Donelook/Differential-Probe/plots/Differential Probe__Assembly.pdf

1 | 2 | 3 | 4 | 5 | 6

A

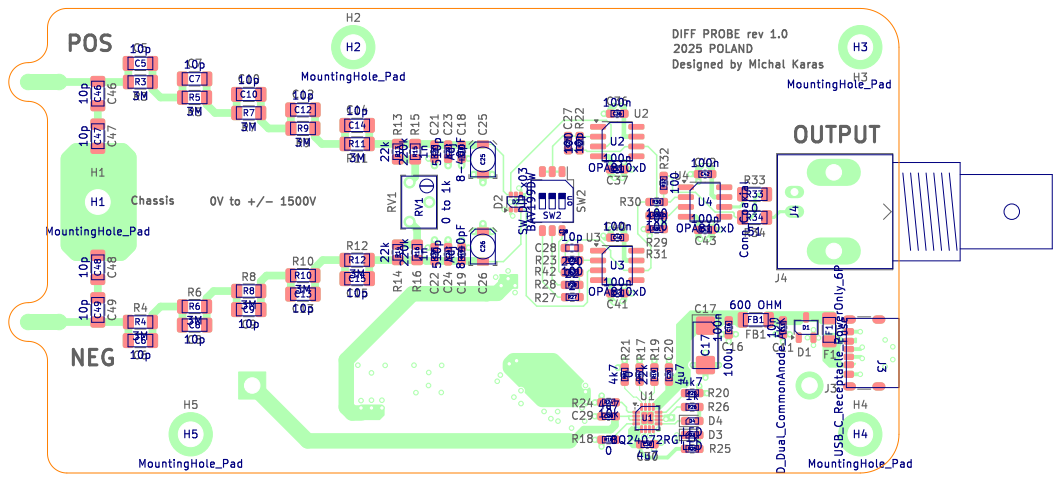
[picture p1: page 1]

A

A

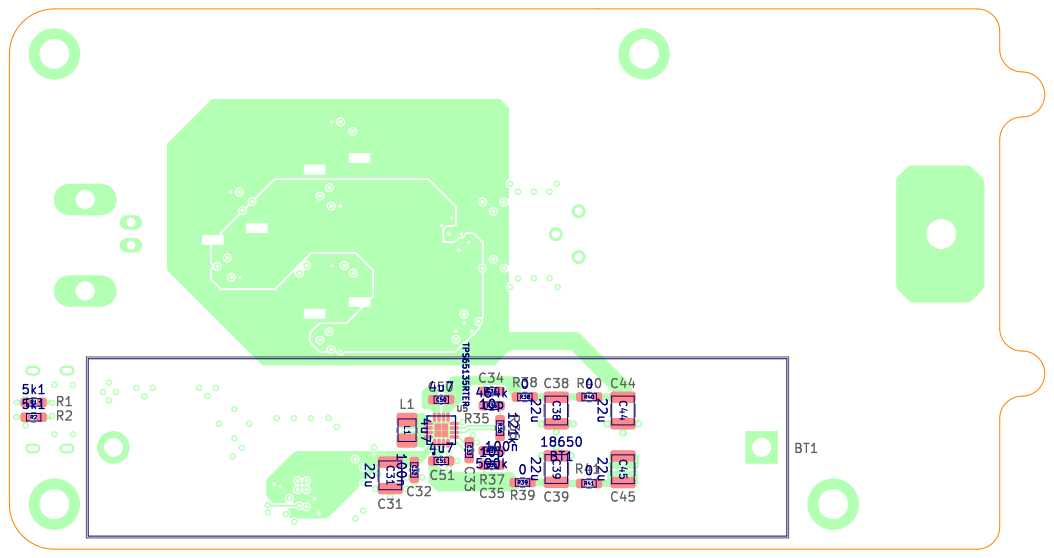
[picture p2: page 2]

A

A

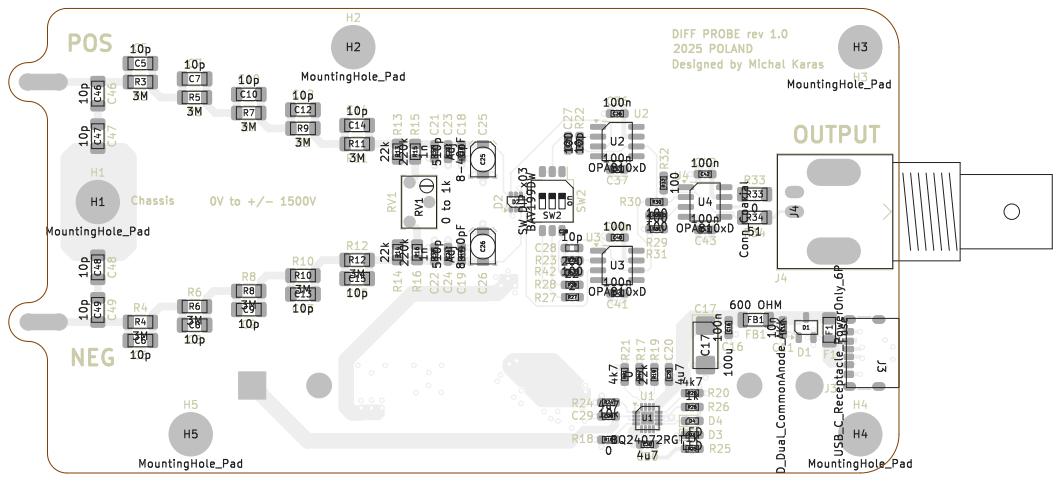
[picture p3: page 3]

A

A

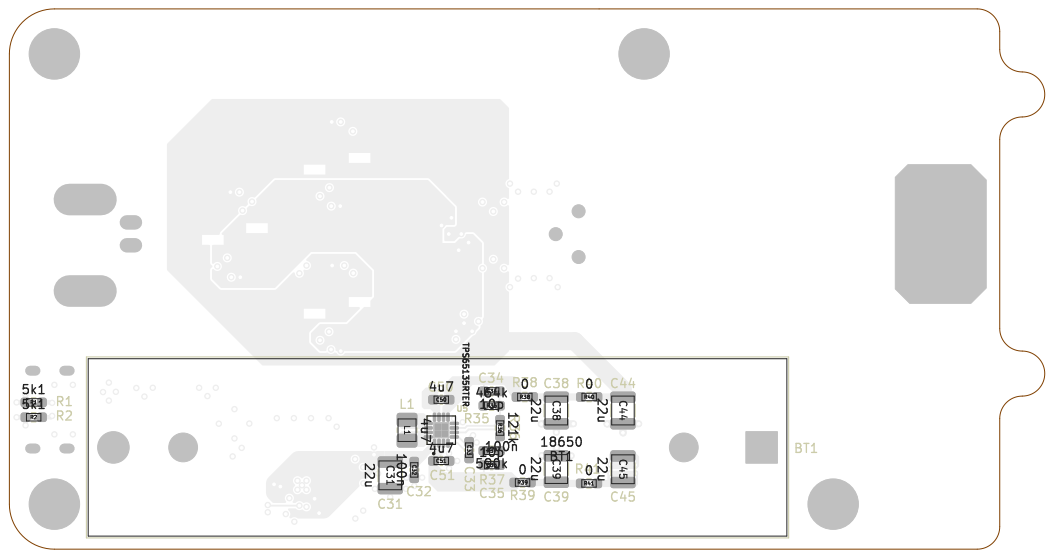
[picture p4: page 4]
