Donelook/Differential-Probe/Symulacja/dIFFERENTIAL PROBE.asc

C1: cap; 10p
C2: cap; 10p
C3: cap; 10p
C4: cap; 10p
C5: cap; 10p
C6: cap; 10p
C7: cap; 10p
C8: cap; 10p
C9: cap; 10p
C10: cap; 10p
C11: cap; 1.51n
C12: cap; 1.51n
C15: cap; 5p; Rser=1m Lser=2n
C16: cap; 5p; Rser=1m Lser=2n
L1: ind; 2n
L2: ind; 2n
R1: res; 3Meg
R2: res; 3Meg
R3: res; 20k
R4: res; 3Meg
R5: res; 3Meg
R6: res; 3Meg
R7: res; 3Meg
R8: res; 3Meg
R9: res; 3Meg
R10: res; 3Meg
R11: res; 3Meg
R12: res; 20k
R13: res; 100
R14: res; 100
R15: res; 200
R16: res; 100
R17: res; 100
R18: res; 100
R19: res; 100
R20: res; 1Meg
R21: res; 50
U1: OPA820
U2: OPA820
U3: OPA820
V1: voltage; SINE(0 1500 100meg); AC ac 1; Rser=1m
V2: voltage; 6
V3: voltage; 6
V4: voltage; 12
V5: Ammeter
V6: Ammeter
V7: Ammeter
Named nets: 0, plus_, minus_, in+, in-, zas+, zas-, out, test-, test+, +12
.ac dec 1000 1000 1000meg
4Vpp, 2V amplitude for 1500V
8Vpp, 4V amplitude
0.0013315579 GAIN
.ac dec 1000 1000 1000meg
;ac dec 1000 1000 1000meg
.tran 100u
