Donelook/Differential-Probe/Differential Probe.kicad_pcb

## KiCad design Differential Probe.kicad_pcb (2025-03-30)

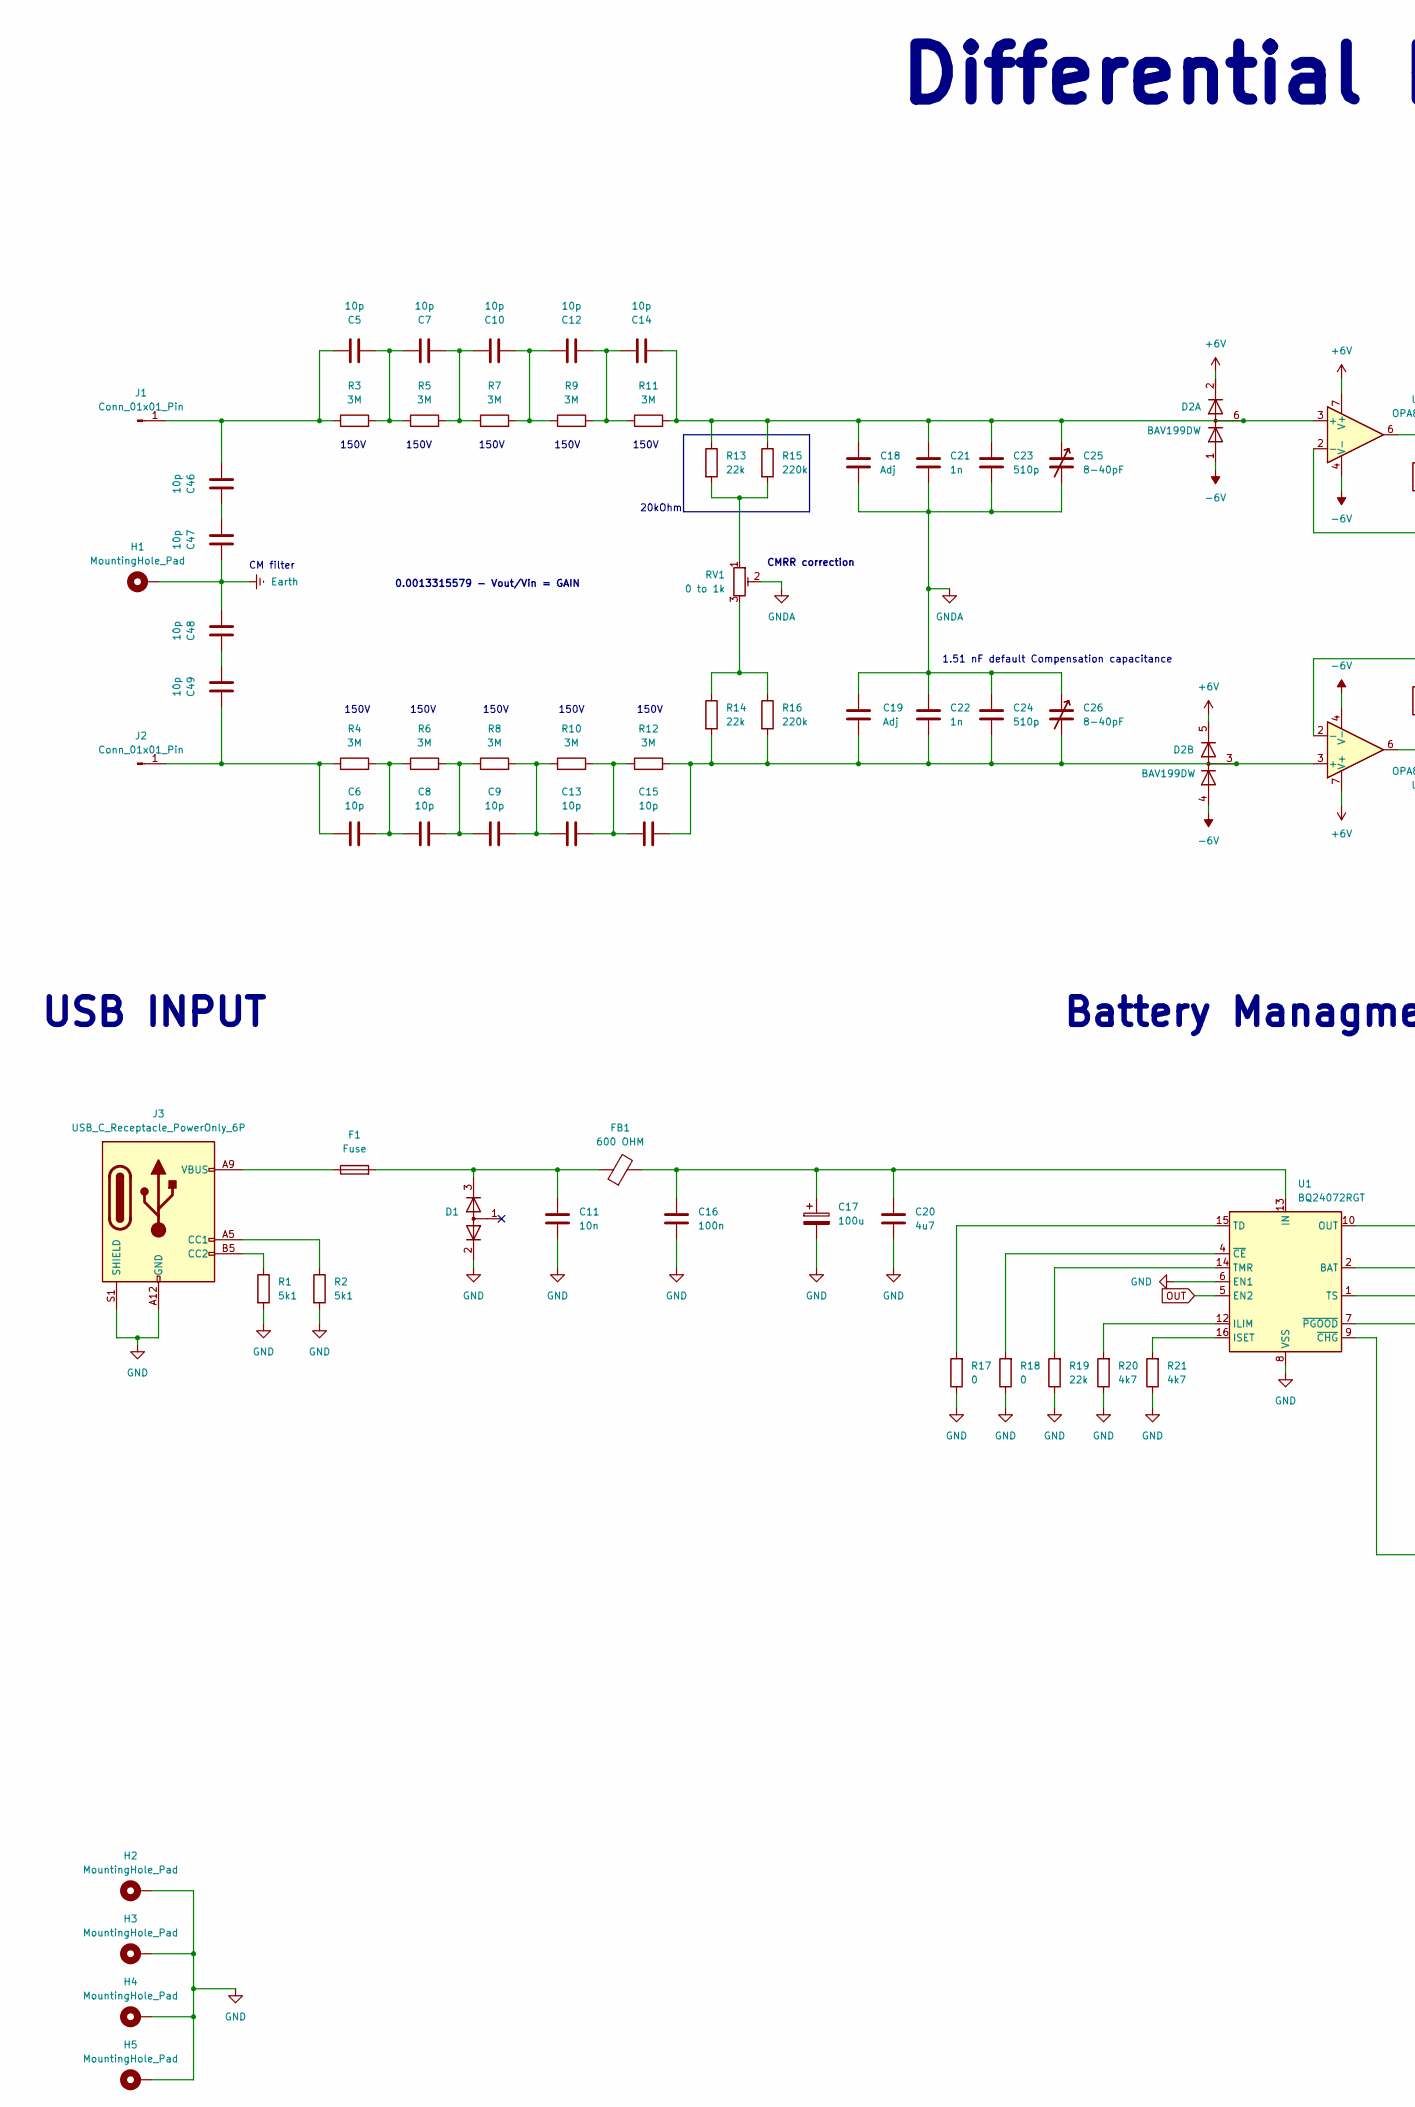
[picture p5: schematic Differential Probe.kicad_sch, part in row 1, column 1]

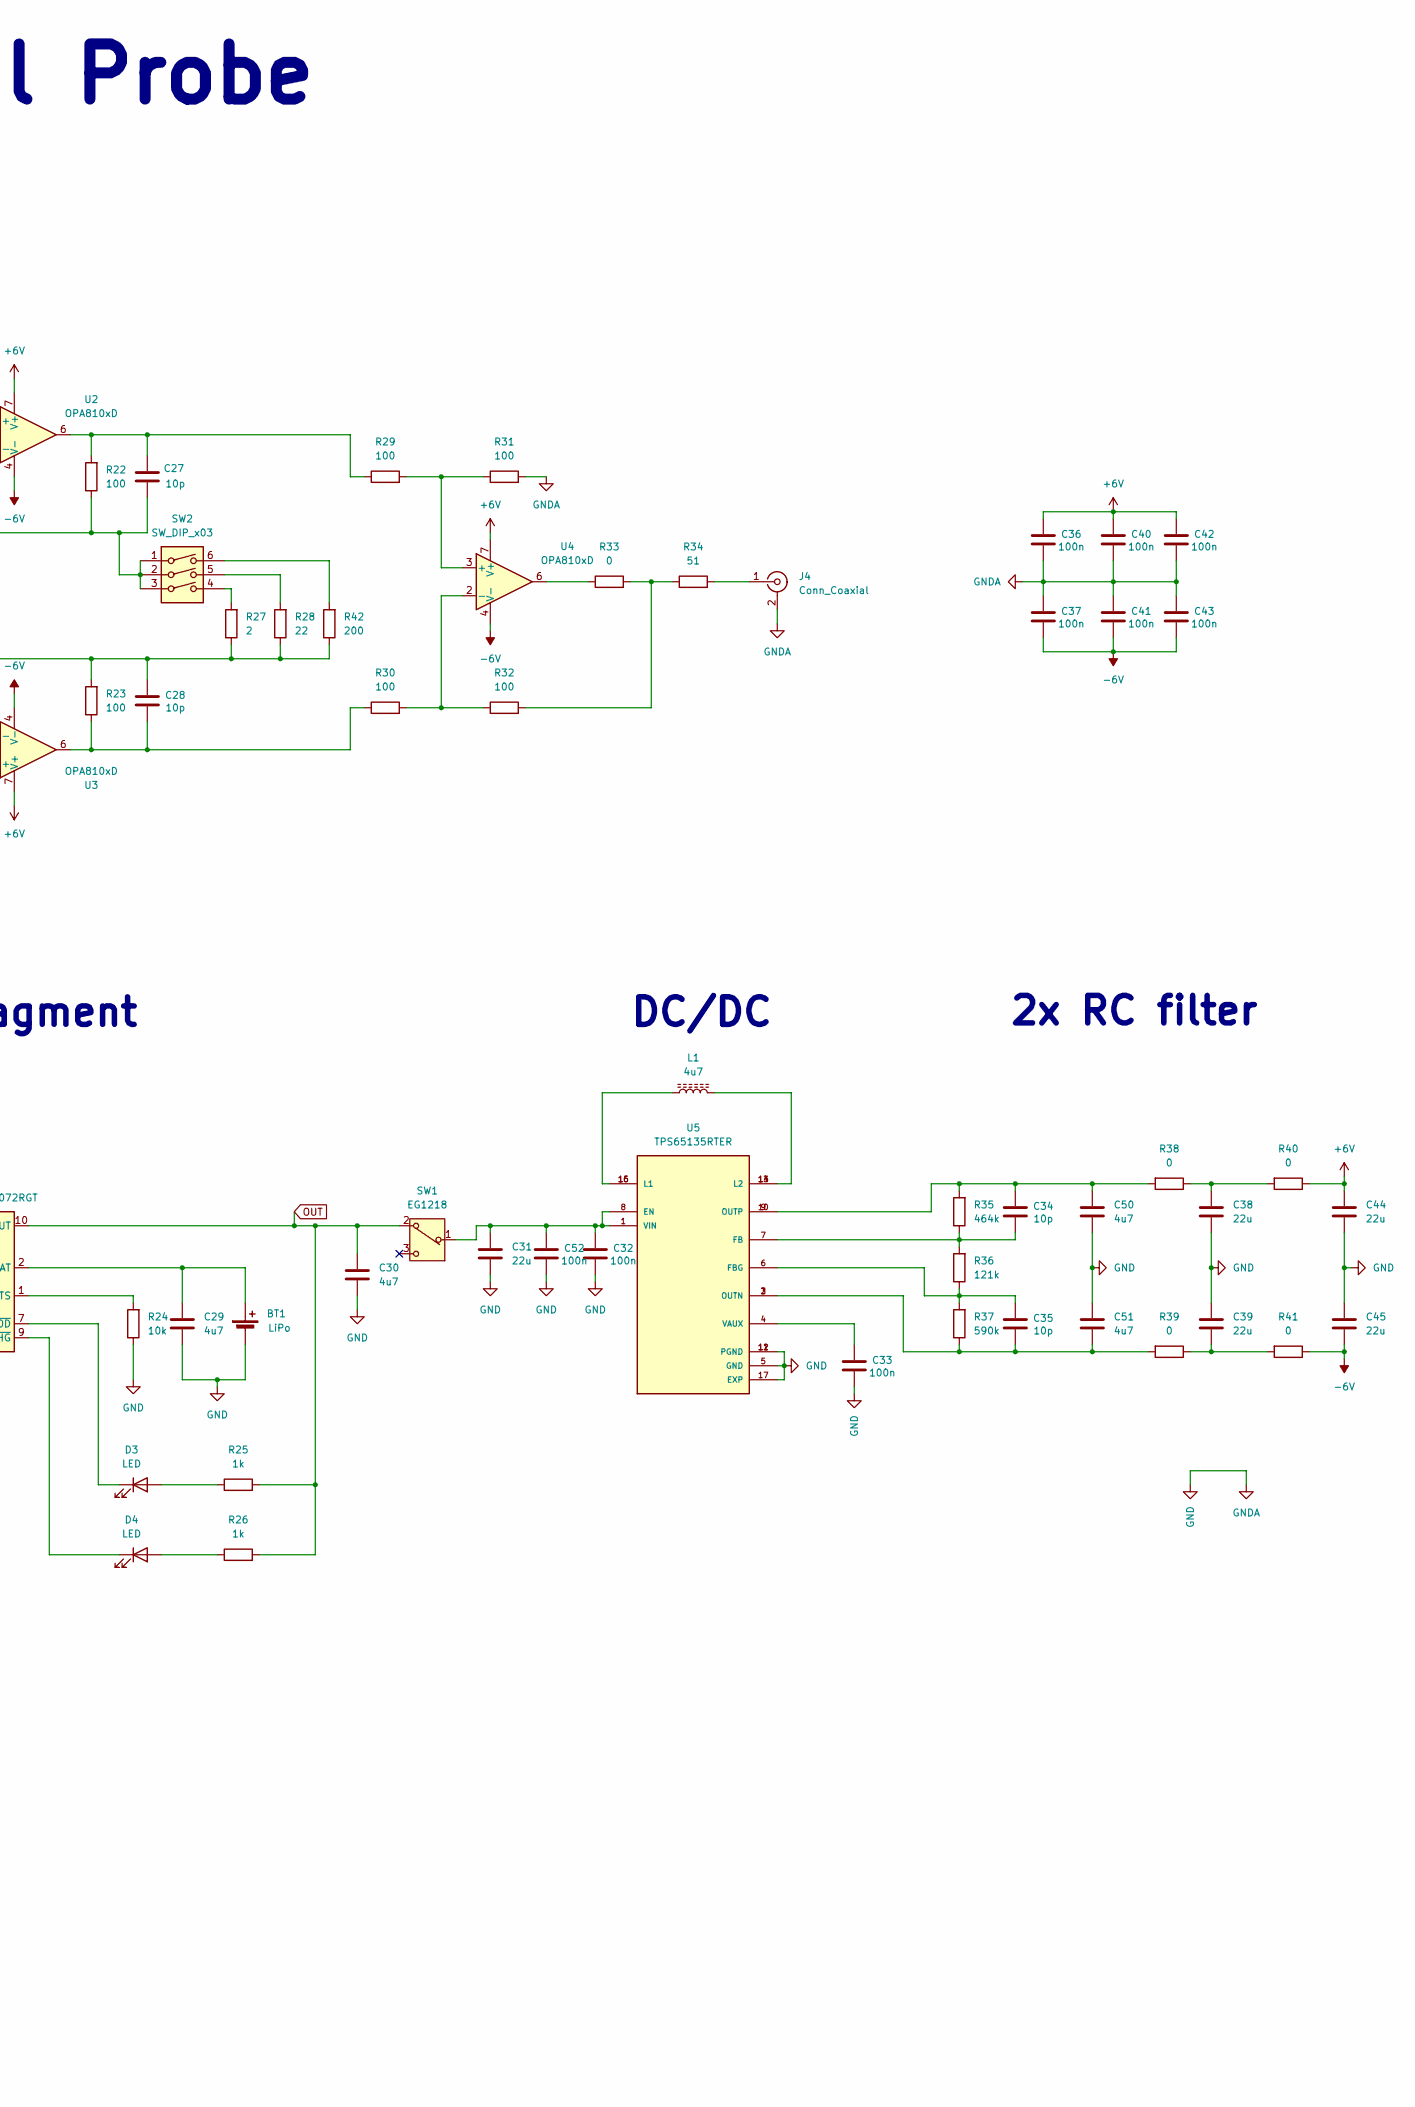
[picture p6: schematic Differential Probe.kicad_sch, part in row 1, column 2]

Parts:
BT1: LiPo; PinHeader_1x02_P2.00mm_Vertical
C5, C6, C7, C8, C9, C10, C12, C13, C14, C15, C46, C47, C48, C49: 10p; C_1206_3216Metric_Pad1.33x1.80mm_HandSolder
C11: 10n; C_0603_1608Metric_Pad1.08x0.95mm_HandSolder
C16, C32, C33, C36, C37, C40, C41, C42, C43, C52: 100n; C_0603_1608Metric_Pad1.08x0.95mm_HandSolder
C17: 100u; CP_EIA-6032-28_Kemet-C_Pad2.25x2.35mm_HandSolder
C18, C19: Adj; C_0603_1608Metric_Pad1.08x0.95mm_HandSolder
C20, C29, C30, C50, C51: 4u7; C_0603_1608Metric_Pad1.08x0.95mm_HandSolder
C21, C22: 1n; C_0603_1608Metric_Pad1.08x0.95mm_HandSolder
C23, C24: 510p; C_0603_1608Metric_Pad1.08x0.95mm_HandSolder
C25, C26: 8-40pF; C_Trimmer_Voltronics_JZ
C27, C28, C34, C35: 10p; C_0603_1608Metric_Pad1.08x0.95mm_HandSolder
C31, C38, C39, C44, C45: 22u; C_1210_3225Metric
D1: D_Dual_CommonAnode_AKK; TSOT-23
D2: BAV199DW; SOT-363_SC-70-6
D3, D4: LED; D_0603_1608Metric_Pad1.05x0.95mm_HandSolder
F1: Fuse; Fuse_1206_3216Metric_Pad1.42x1.75mm_HandSolder
FB1: 600 OHM; L_1206_3216Metric_Pad1.22x1.90mm_HandSolder
H1, H2, H3, H4, H5: MountingHole_Pad; MountingHole_3.2mm_M3_DIN965_Pad
J1, J2: Conn_01x01_Pin; NetTie-2_SMD_Pad2.0mm
J3: USB_C_Receptacle_PowerOnly_6P; USB_C_Receptacle_GCT_USB4125-xx-x-0190_6P_TopMnt_Horizontal
J4: Conn_Coaxial; BNC_Molex_73100-0154-50_Horizontal
L1: 4u7; L_1008_2520Metric_Pad1.43x2.20mm_HandSolder
R1, R2: 5k1; R_0603_1608Metric_Pad0.98x0.95mm_HandSolder
R3, R4, R5, R6, R7, R8, R9, R10, R11, R12: 3M; R_1206_3216Metric_Pad1.30x1.75mm_HandSolder
R13, R14: 22k; R_0805_2012Metric_Pad1.20x1.40mm_HandSolder
R15, R16: 220k; R_0805_2012Metric_Pad1.20x1.40mm_HandSolder
R17, R18, R38, R39, R40, R41: 0; R_0603_1608Metric_Pad0.98x0.95mm_HandSolder
R19: 22k; R_0603_1608Metric_Pad0.98x0.95mm_HandSolder
R20, R21: 4k7; R_0603_1608Metric_Pad0.98x0.95mm_HandSolder
R22, R23, R29, R30, R31, R32: 100; R_0603_1608Metric_Pad0.98x0.95mm_HandSolder
R24: 10k; R_0603_1608Metric_Pad0.98x0.95mm_HandSolder
R25, R26: 1k; R_0603_1608Metric_Pad0.98x0.95mm_HandSolder
R27: 2; R_0603_1608Metric_Pad0.98x0.95mm_HandSolder
R28: 22; R_0603_1608Metric_Pad0.98x0.95mm_HandSolder
R33: 0; R_1206_3216Metric_Pad1.30x1.75mm_HandSolder
R34: 51; R_1206_3216Metric_Pad1.30x1.75mm_HandSolder
R35: 464k; R_0603_1608Metric_Pad0.98x0.95mm_HandSolder
R36: 121k; R_0603_1608Metric_Pad0.98x0.95mm_HandSolder
R37: 590k; R_0603_1608Metric_Pad0.98x0.95mm_HandSolder
R42: 200; R_0603_1608Metric_Pad0.98x0.95mm_HandSolder
RV1: 0 to 1k; Potentiometer_Bourns_3266W_Vertical
SW1: EG1218; SW_Slide-03_Wuerth-WS-SLTV_10x2.5x6.4_P2.54mm
SW2: SW_DIP_x03; SW_DIP_SPSTx03_Slide_KingTek_DSHP03TS_W7.62mm_P1.27mm
U1: BQ24072RGT; VQFN-16-1EP_3x3mm_P0.5mm_EP1.6x1.6mm
U2, U3, U4: OPA810xD; SOIC-8_3.9x4.9mm_P1.27mm
U5: TPS65135RTER; QFN50P300X300X80-17N; PARTREV January 2017

Connections:
+6V: C36.1, C40.1, C42.1, C44.1, D2.2 (K2), D2.5 (K4), R40.1, U2.7 (V+), U3.7 (V+), U4.7 (V+)
-6V: C37.2, C41.2, C43.2, C45.2, D2.1 (A1), D2.4 (A3), R41.1, U2.4 (V-), U3.4 (V-), U4.4 (V-)
Earth: C47.2, C48.1, H1.1
GND: BT1.2 (-), C11.2, C16.2, C17.2, C18.2, C19.1, C20.2, C21.2, C22.1, C23.2, C24.1, C25.2, C26.1, C29.2, C30.2, C31.2, C32.2, C33.2, C36.2, C37.1, C38.2, C39.1, C40.2, C41.1, C42.2, C43.1, C44.2, C45.1, C50.2, C51.1, C52.2, D1.2 (K), H2.1, H3.1, H4.1, H5.1, J3.A12 (GND), J3.B12 (GND), J3.S1 (SHIELD), J4.2 (Ext), R1.2, R2.2, R17.1, R18.1, R19.1, R20.1, R21.1, R24.1, R31.2, RV1.2, U1.6 (EN1), U1.8 (VSS), U1.17 (VSS), U5.5 (GND), U5.11 (PGND), U5.12 (PGND), U5.17 (EXP)
unnamed: BT1.1 (+), C29.1, U1.2 (BAT), U1.3 (BAT)
unnamed: C5.1, C7.2, R3.2, R5.1
unnamed: C6.2, C8.1, R4.2, R6.1
unnamed: C8.2, C9.1, R6.2, R8.1
unnamed: C10.1, C12.2, R7.2, R9.1
unnamed: C7.1, C10.2, R5.2, R7.1
unnamed: C11.1, D1.3 (K), F1.2, FB1.1
unnamed: C12.1, C14.2, R9.2, R11.1
unnamed: C9.2, C13.1, R8.2, R10.1
unnamed: C13.2, C15.1, R10.2, R12.1
unnamed: C27.1, R22.2, R29.1, U2.6
unnamed: C28.2, R23.1, R30.1, U3.6
unnamed: C34.1, C50.1, R35.2, R38.2, U5.9 (OUTP), U5.10 (OUTP)
unnamed: C35.2, C51.2, R37.1, R39.2, U5.2 (OUTN), U5.3 (OUTN)
unnamed: C38.1, R38.1, R40.2
unnamed: C39.2, R39.1, R41.2
unnamed: C46.2, C47.1
unnamed: C48.2, C49.1
unnamed: C14.1, C18.1, C21.1, C23.1, C25.1, D2.6 (K3A4), R11.2, R13.1, R15.1, U2.3 (+)
unnamed: C15.2, C19.2, C22.2, C24.2, C26.2, D2.3 (K1A2), R12.2, R14.2, R16.2, U3.3 (+)
unnamed: D3.2 (A), R25.1
unnamed: D3.1 (K), U1.7 (~PGOOD)
unnamed: D4.2 (A), R26.1
unnamed: D4.1 (K), U1.9 (~CHG)
unnamed: F1.1, J3.A9 (VBUS), J3.B9 (VBUS)
unnamed: C5.2, C46.1, J1.1, R3.1
unnamed: C6.1, C49.2, J2.1, R4.1
unnamed: J3.A5 (CC1), R2.1
unnamed: J3.B5 (CC2), R1.1
unnamed: J4.1 (In), R34.2
unnamed: L1.1, U5.15 (L1), U5.16 (L1)
unnamed: L1.2, U5.13 (L2), U5.14 (L2)
unnamed: R13.2, R15.2, RV1.1
unnamed: R14.1, R16.1, RV1.3
unnamed: R27.2, SW2.4
unnamed: R28.2, SW2.5
unnamed: R32.2, R33.2, R34.1
unnamed: R33.1, U4.6
unnamed: R42.2, SW2.6
unnamed: C31.1, C32.1, C52.1, SW1.1 (B), U5.1 (VIN), U5.8 (EN)
unnamed: R20.2, U1.12 (ILIM)
unnamed: C16.1, C17.1, C20.1, FB1.2, U1.13 (IN)
unnamed: R21.2, U1.16 (ISET)
unnamed: R17.2, U1.15 (TD)
unnamed: R19.2, U1.14 (TMR)
unnamed: R24.2, U1.1 (TS)
unnamed: R18.2, U1.4 (~CE)
unnamed: C27.2, R22.1, SW2.1, SW2.2, SW2.3, U2.2 (-)
unnamed: C28.1, R23.2, R27.1, R28.1, R42.1, U3.2 (-)
unnamed: R29.2, R31.1, U4.3 (+)
unnamed: R30.2, R32.1, U4.2 (-)
unnamed: C34.2, R35.1, R36.2, U5.7 (FB)
unnamed: C35.1, R36.1, R37.2, U5.6 (FBG)
unnamed: C33.1, U5.4 (VAUX)
OUT: C30.1, R25.2, R26.2, SW1.2 (C), U1.5 (EN2), U1.10 (OUT), U1.11 (OUT)

Notes on the sheet:
1.51 nF default Compensation capacitance
20kOhm
CM filter
150V
USB INPUT
CMRR correction
Differential Probe
2x RC filter
0.0013315579 - Vout/Vin = GAIN
Battery Managment
DC/DC

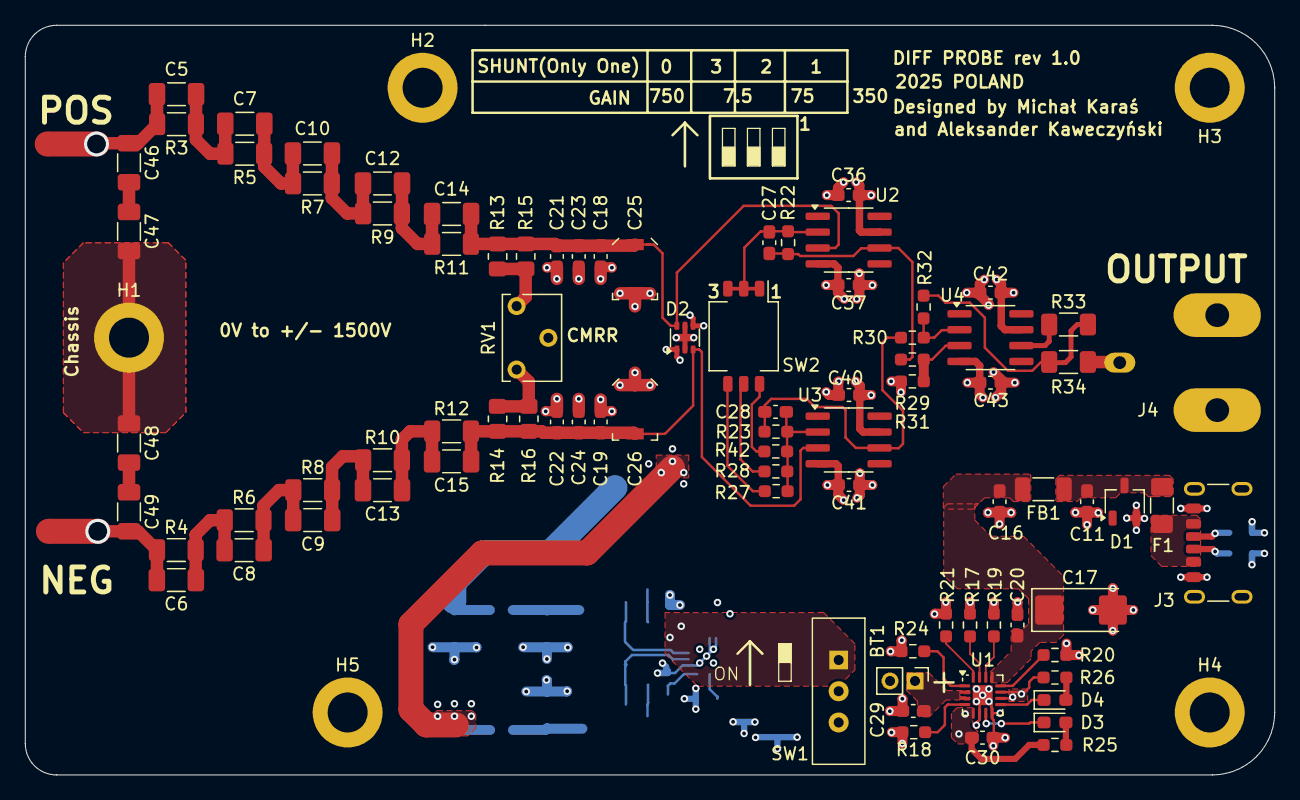
[picture p7: board Differential Probe.kicad_pcb from above]

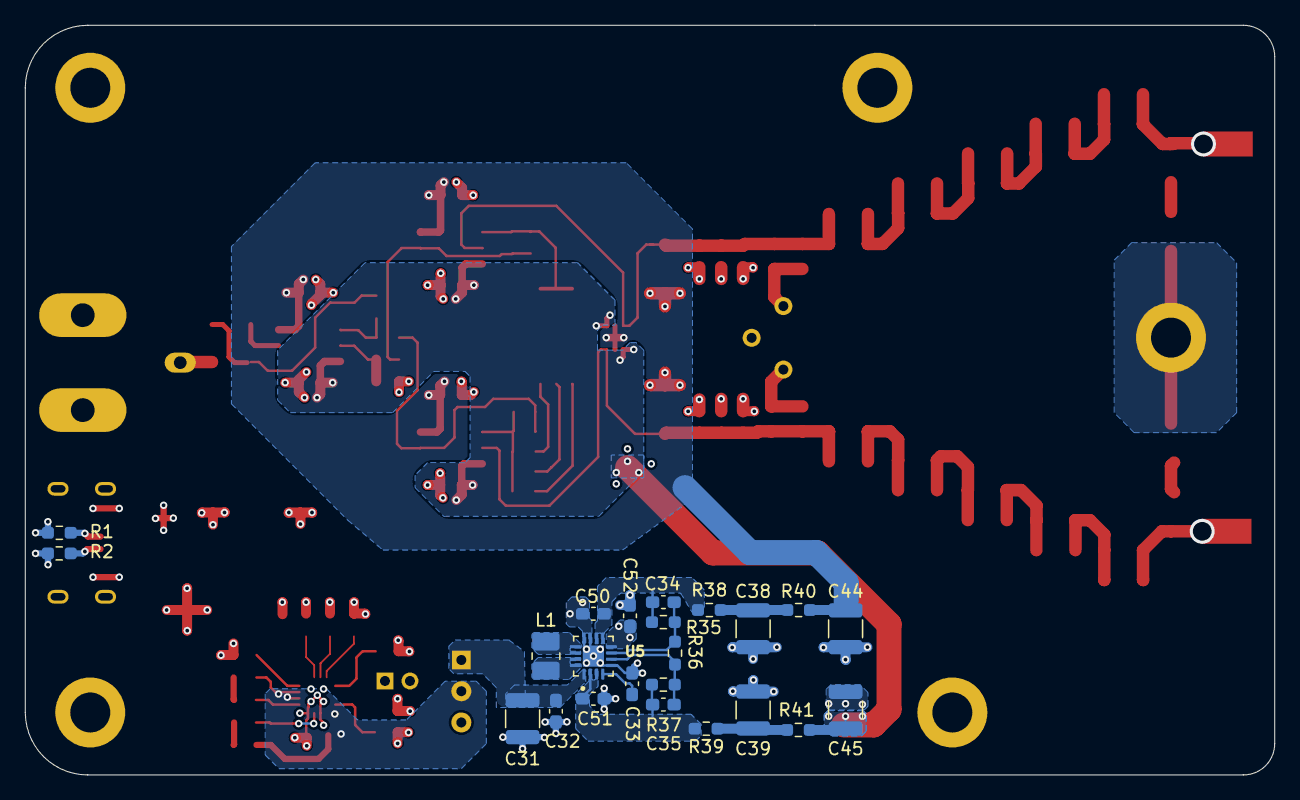
[picture p8: board Differential Probe.kicad_pcb from below]

Board: 4 copper layers, 100.0 x 60.0 mm, 115 parts (23 on the bottom side), 59 nets.
