Donelook/Differential-Probe/(commit log)

2025-03-23 first push
    [Differential Probe.kicad_pcb, Differential Probe.kicad_sch, Lista elemntow.xlsx]
2025-03-23 Next work push
    added callculator for instrumental ampl
    [Differential Probe.kicad_sch, Lista elemntow.xlsx]
2025-03-24 battery circuit added
    [Differential Probe.kicad_sch]
2025-03-25 Layout started
    [Differential Probe.kicad_pcb, Differential Probe.kicad_sch, Lista elemntow.xlsx]
2025-03-28 PCB layout 90%
    [Differential Probe.kicad_pcb, Differential Probe.kicad_sch]
2025-03-29 Ready to check
    [Differential Probe.kicad_pcb, Differential Probe.kicad_sch, bom.csv, designators.csv, positions.csv]
2025-03-29 3D model added
    BNC
    [Differential Probe.kicad_pcb]
